maplac/RgbStripWebServer/Images/finished_device.jpg

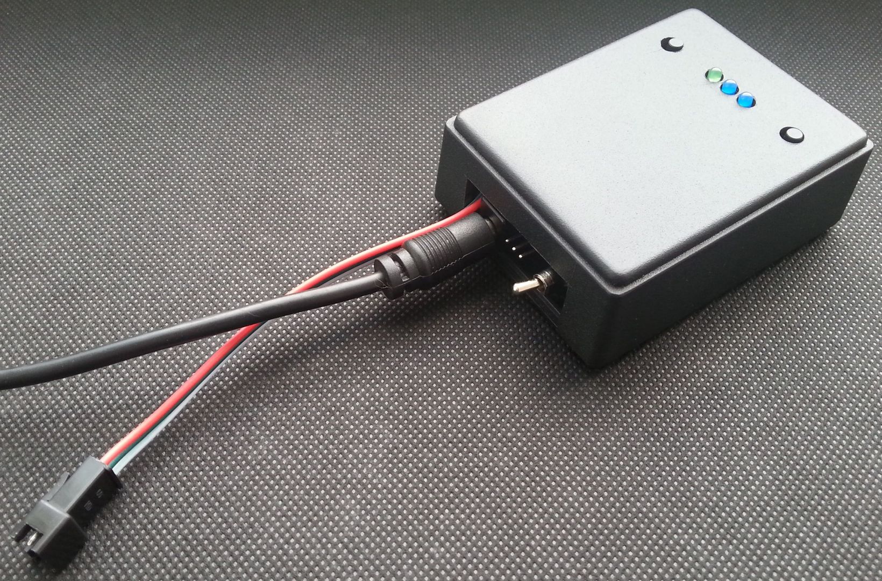
Images/finished_device.jpg
