maplac/RgbStripWebServer/Images/populated_pcb_top.jpg

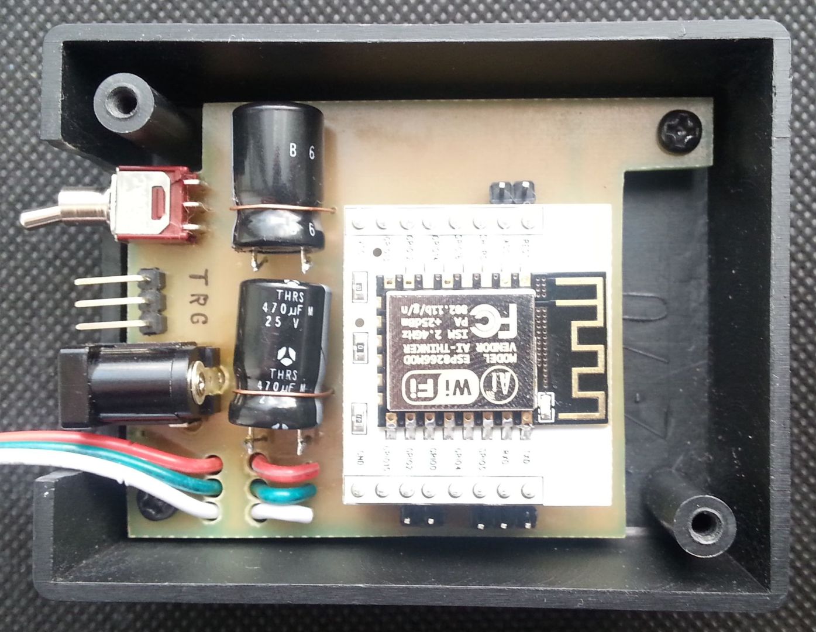
Images/populated_pcb_top.jpg
