maplac/RgbStripWebServer/Images/device_in_use.jpg

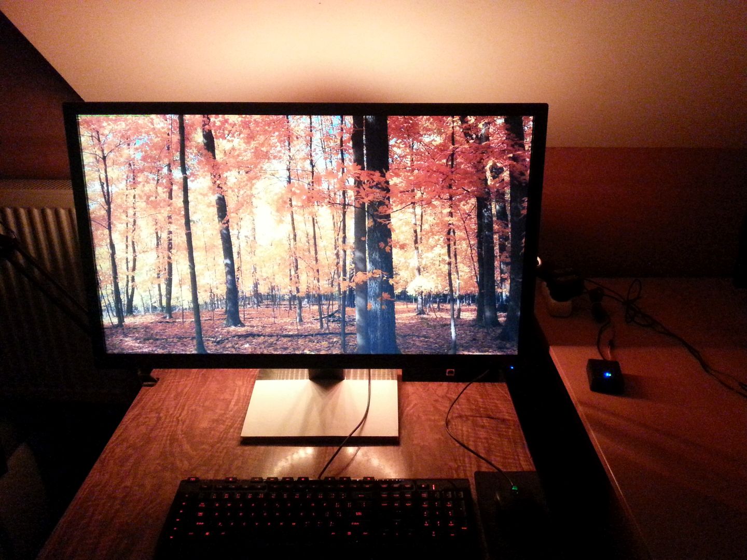
Images/device_in_use.jpg
