maplac/RgbStripWebServer/Images/led_strip_on_cardboard.jpg

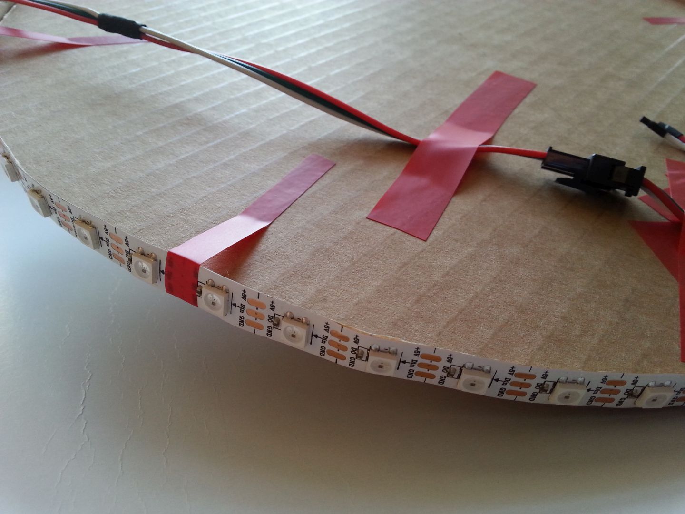
Images/led_strip_on_cardboard.jpg
