maplac/RgbStripWebServer/Images/populated_pcb_bottom.jpg

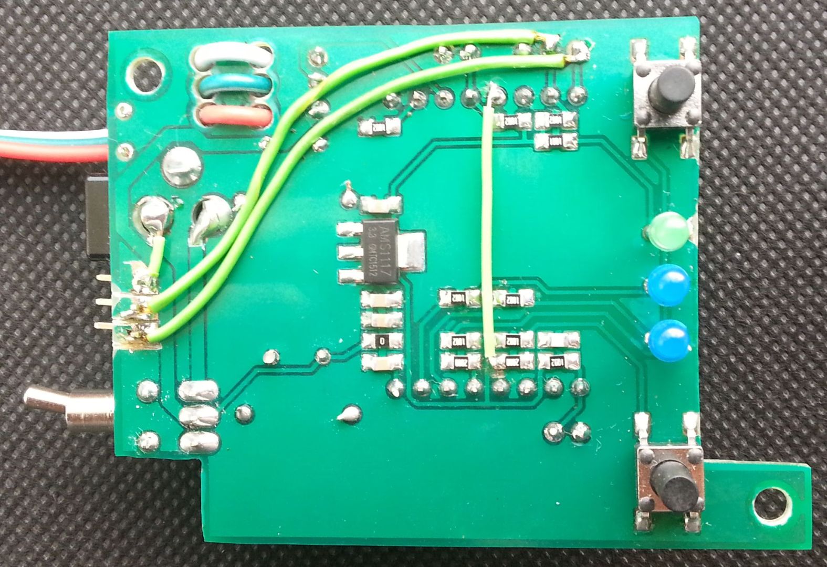
Images/populated_pcb_bottom.jpg
