maplac/RgbStripWebServer/Images/screenshot_home.png

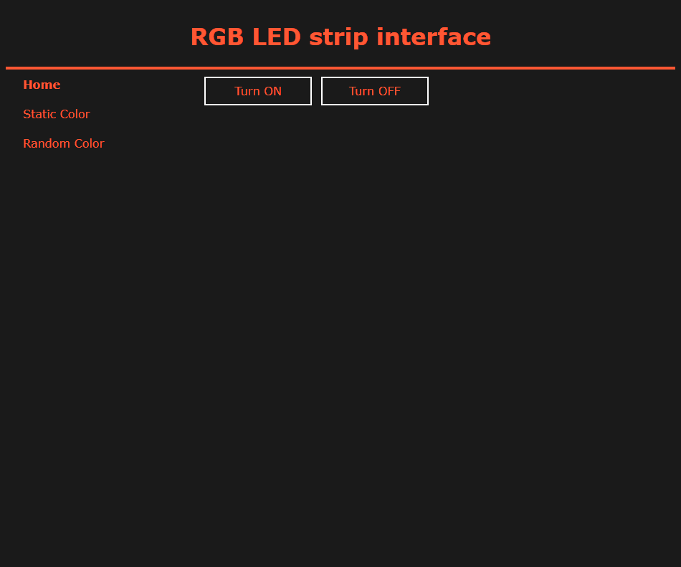
Images/screenshot_home.png
