maplac/RgbStripWebServer/Images/screenshot_random_color.png

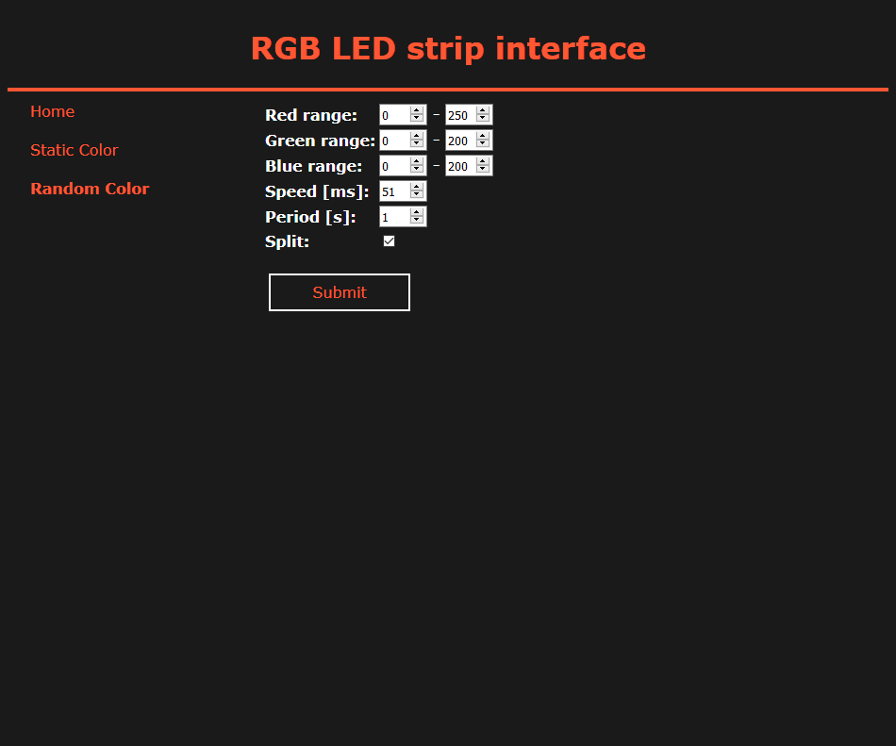
Images/screenshot_random_color.png
