maplac/RgbStripWebServer/Images/screenshot_static_color.png

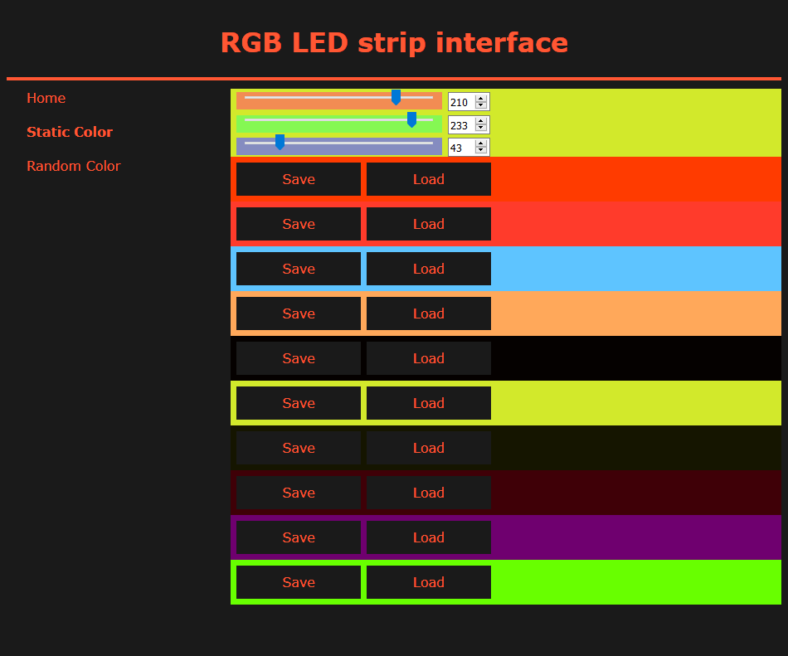
Images/screenshot_static_color.png
