maplac/RgbStripWebServer/PCB/bottom-mask.png

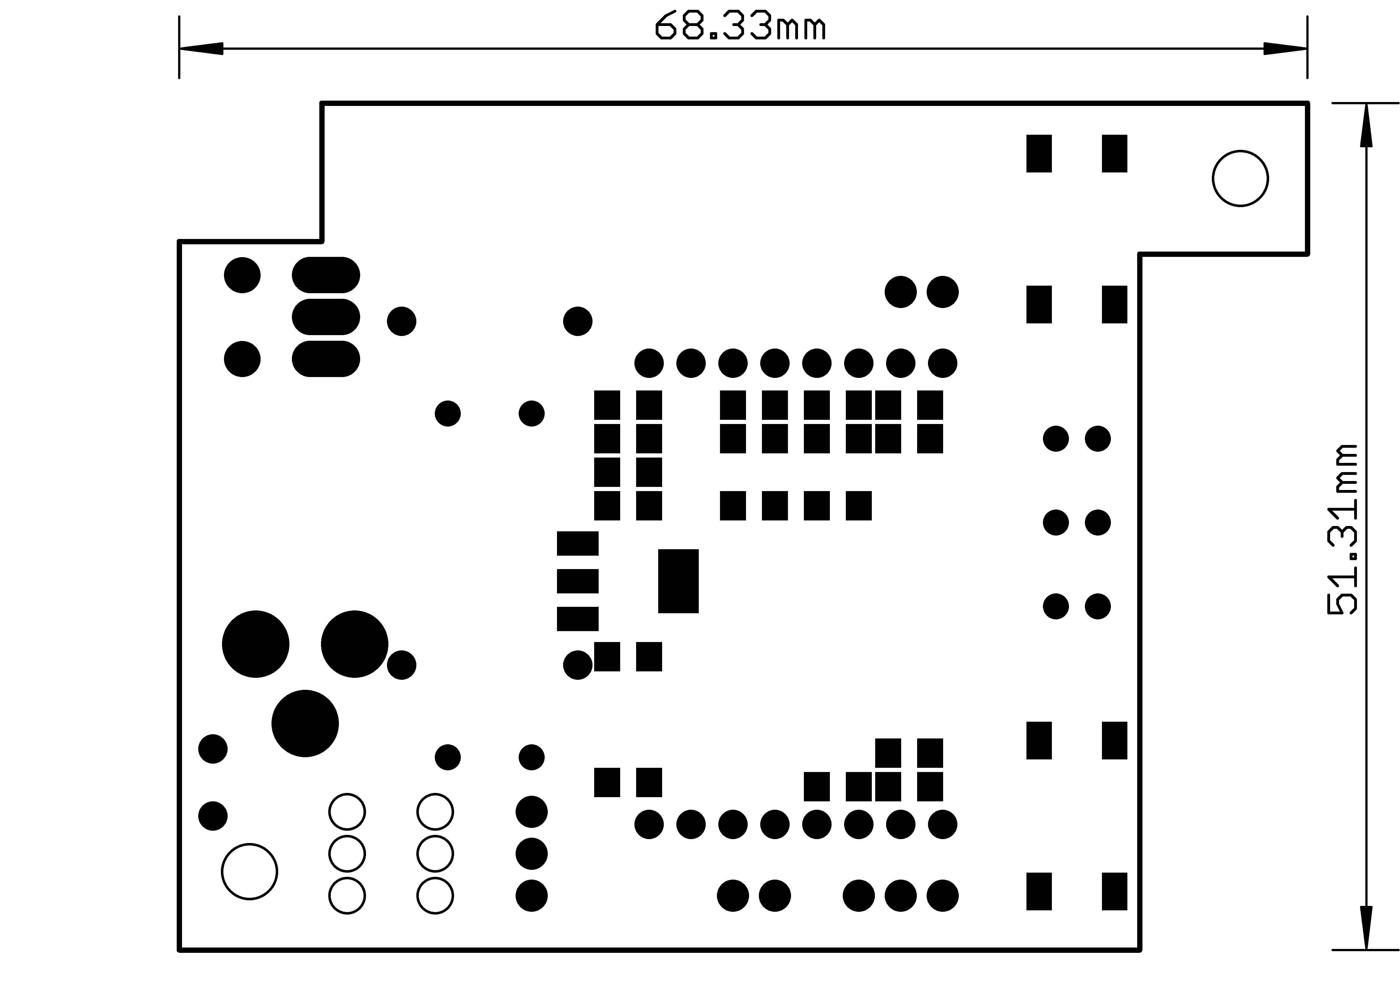
PCB/bottom-mask.png
