maplac/RgbStripWebServer/PCB/bottom.png

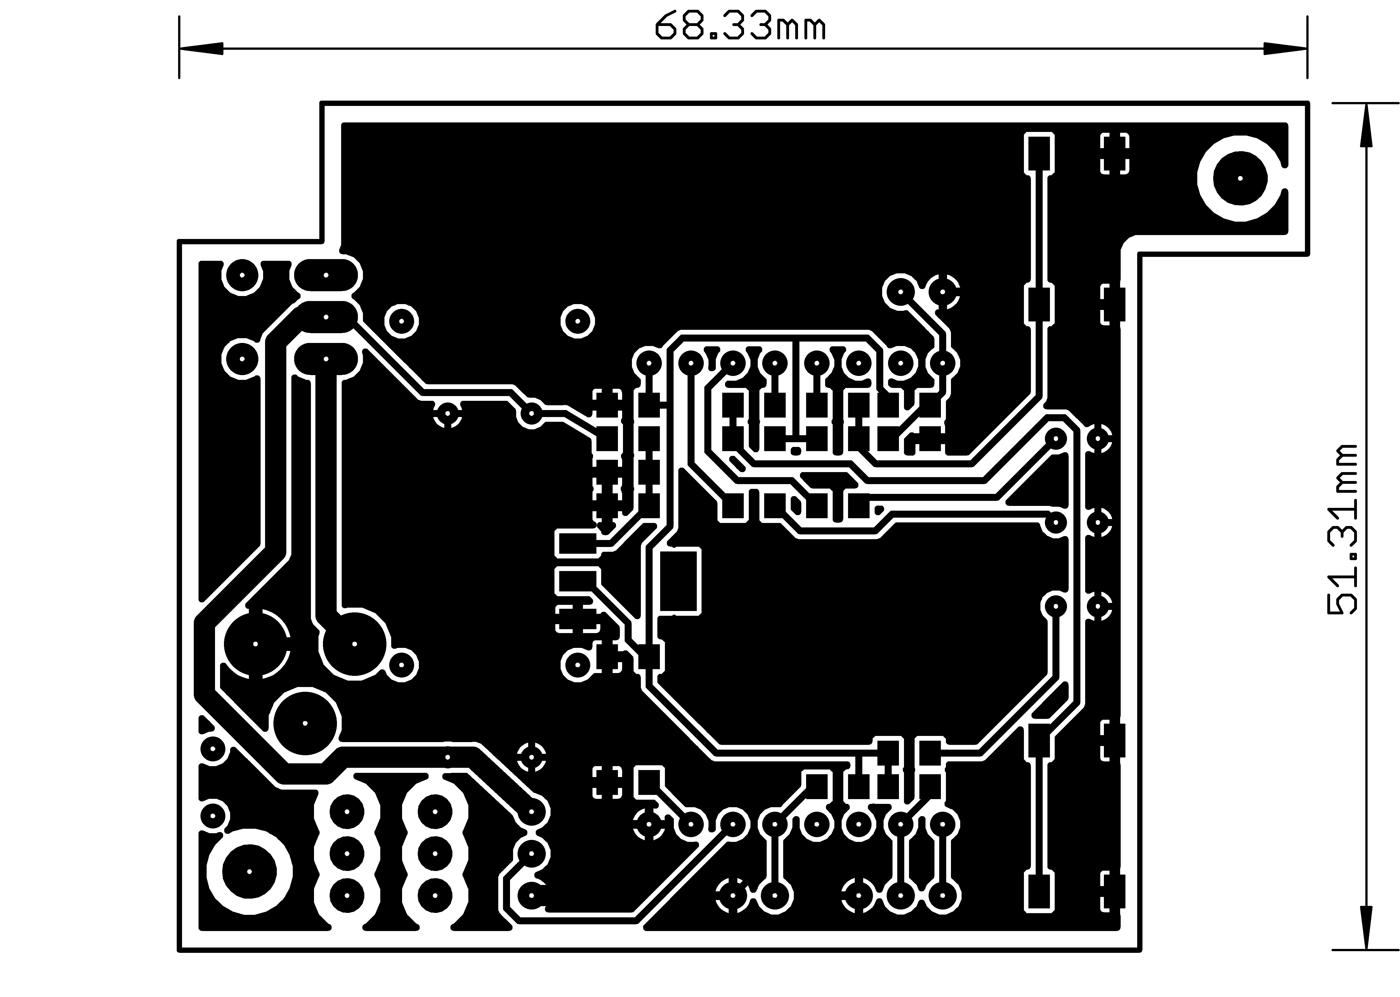
PCB/bottom.png
