maplac/RgbStripWebServer/PCB/schematics.png

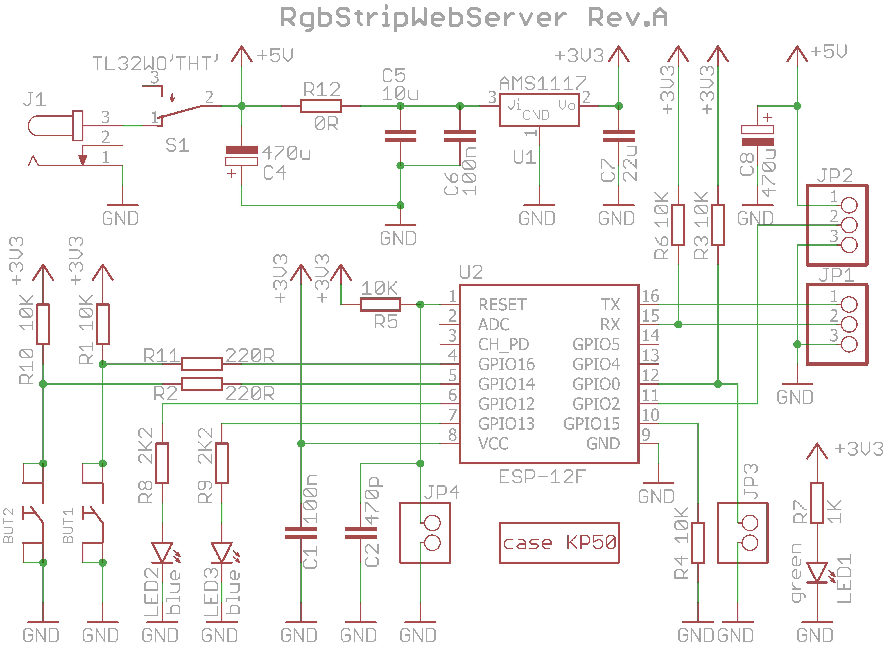
PCB/schematics.png
