maplac/RgbStripWebServer/PCB/bottom-parts-names.png

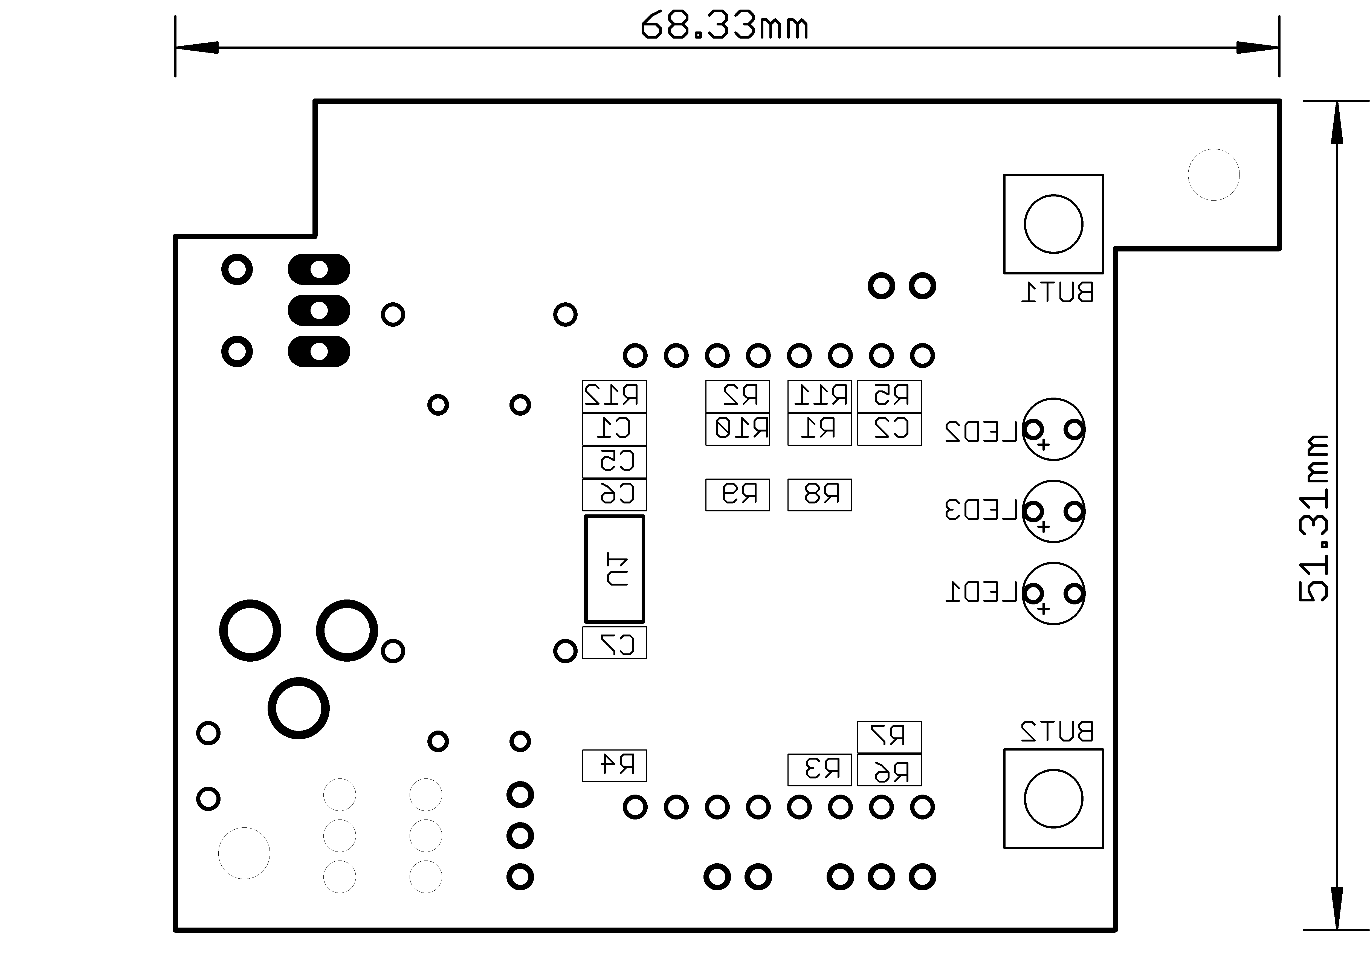
PCB/bottom-parts-names.png
