maplac/RgbStripWebServer/PCB/top-parts.png

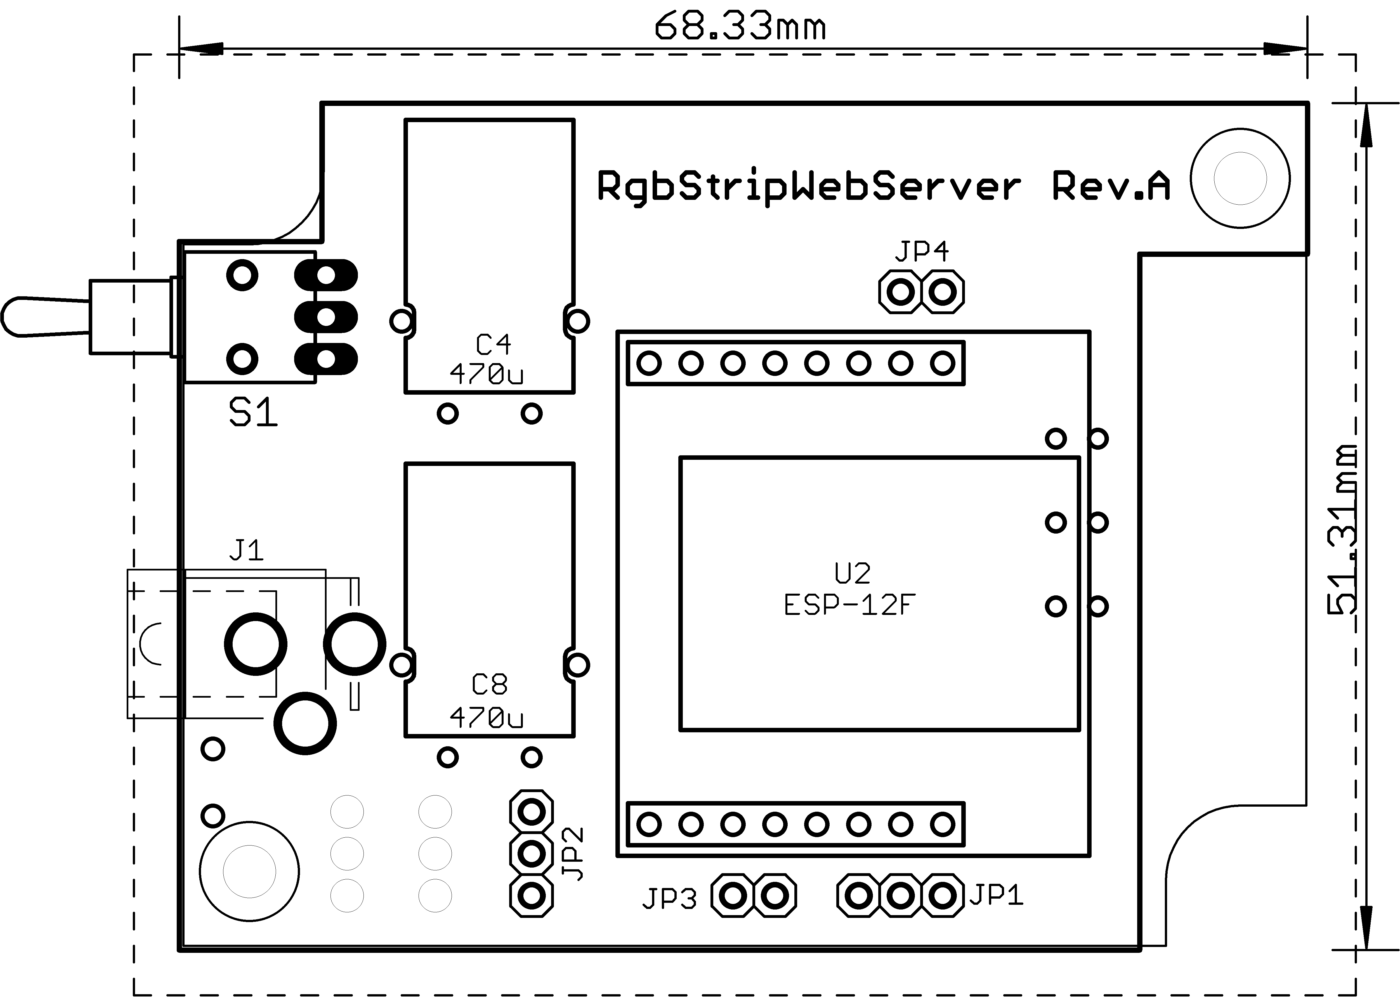
PCB/top-parts.png
