maplac/RgbStripWebServer/PCB/ESP_rgb_led_server_revA.brd

## EAGLE design PCB/ESP_rgb_led_server_revA.brd (2017-05-15)

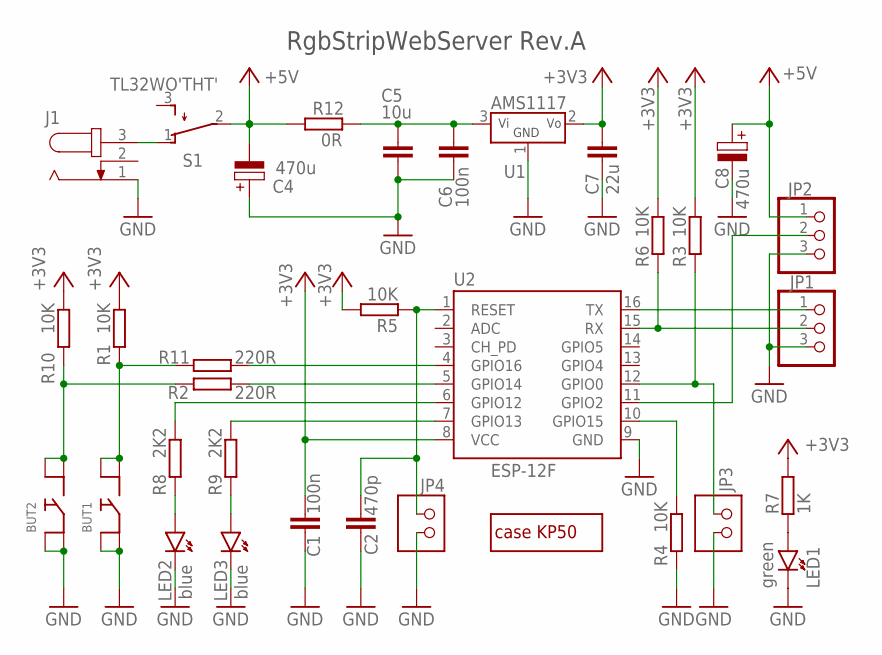
[picture p14: schematic ESP_rgb_led_server_revA.sch]

Parts:
BUT1, BUT2: BUTTON'SMD'; BUTTON_SMD
C1, C6: 100n; C0805
C2: 470p; C0805
C4, C8: 470u; ELYT-10MM/90
C5: 10u; C0805
C7: 22u; C0805
J1: JACK-PLUG1; SPC4078
JP1, JP2: PINHD-3X1
JP3, JP4: PINHD-2X1
LED1: green; LED3MM
LED2, LED3: blue; LED3MM
R1, R3, R4, R5, R6, R10: 10K; R0805
R2, R11: 220R; R0805
R7: 1K; R0805
R8, R9: 2K2; R0805
R12: 0R; R0805
S1: TL32WO'THT'; TL3XWO
U1: AMS1117; SOT223
U2: ESP-12F; ESP-12F-ADAPTER
U$1: CASE-KP50; KP50-CASE

Connections:
+3V3: C1.2, C7.2, R1.2, R3.2, R5.2, R6.2, R7.2, R10.2, U1.2 (VOUT), U2.8 (VCC)
+5V: C4.N (NEG), C8.P (POS), JP2.1, R12.2, S1.2
GND: BUT1.1 (4), BUT1.2, BUT2.1 (4), BUT2.2, C1.1, C2.1, C4.P (POS), C5.1, C6.1, C7.1, C8.N (NEG), J1.1, JP1.3, JP2.3, JP3.2, JP4.2, LED1.K, LED2.K, LED3.K, R4.1, U1.1 (GND), U2.9 (GND)
unnamed: JP1.1, U2.16 (TX)
unnamed: JP3.1, R3.1, U2.12 (GPIO0)
unnamed: C2.2, JP4.1, R5.1, U2.1 (RESET)
unnamed: R4.2, U2.10 (GPIO15)
unnamed: JP1.2, R6.1, U2.15 (RX)
unnamed: JP2.2, U2.11 (GPIO2)
unnamed: J1.3, S1.1 (O)
unnamed: R11.2, U2.4 (GPIO16)
unnamed: LED1.A, R7.1
unnamed: R2.2, U2.5 (GPIO14)
unnamed: R8.2, U2.6 (GPIO12)
unnamed: LED2.A, R8.1
unnamed: R9.2, U2.7 (GPIO13)
unnamed: LED3.A, R9.1
unnamed: BUT2.3 (1), BUT2.4 (3), R2.1, R10.1
unnamed: C5.2, C6.2, R12.1, U1.3 (VIN)
unnamed: BUT1.3 (1), BUT1.4 (3), R1.1, R11.1

Notes on the sheet:
RgbStripWebServer Rev.A

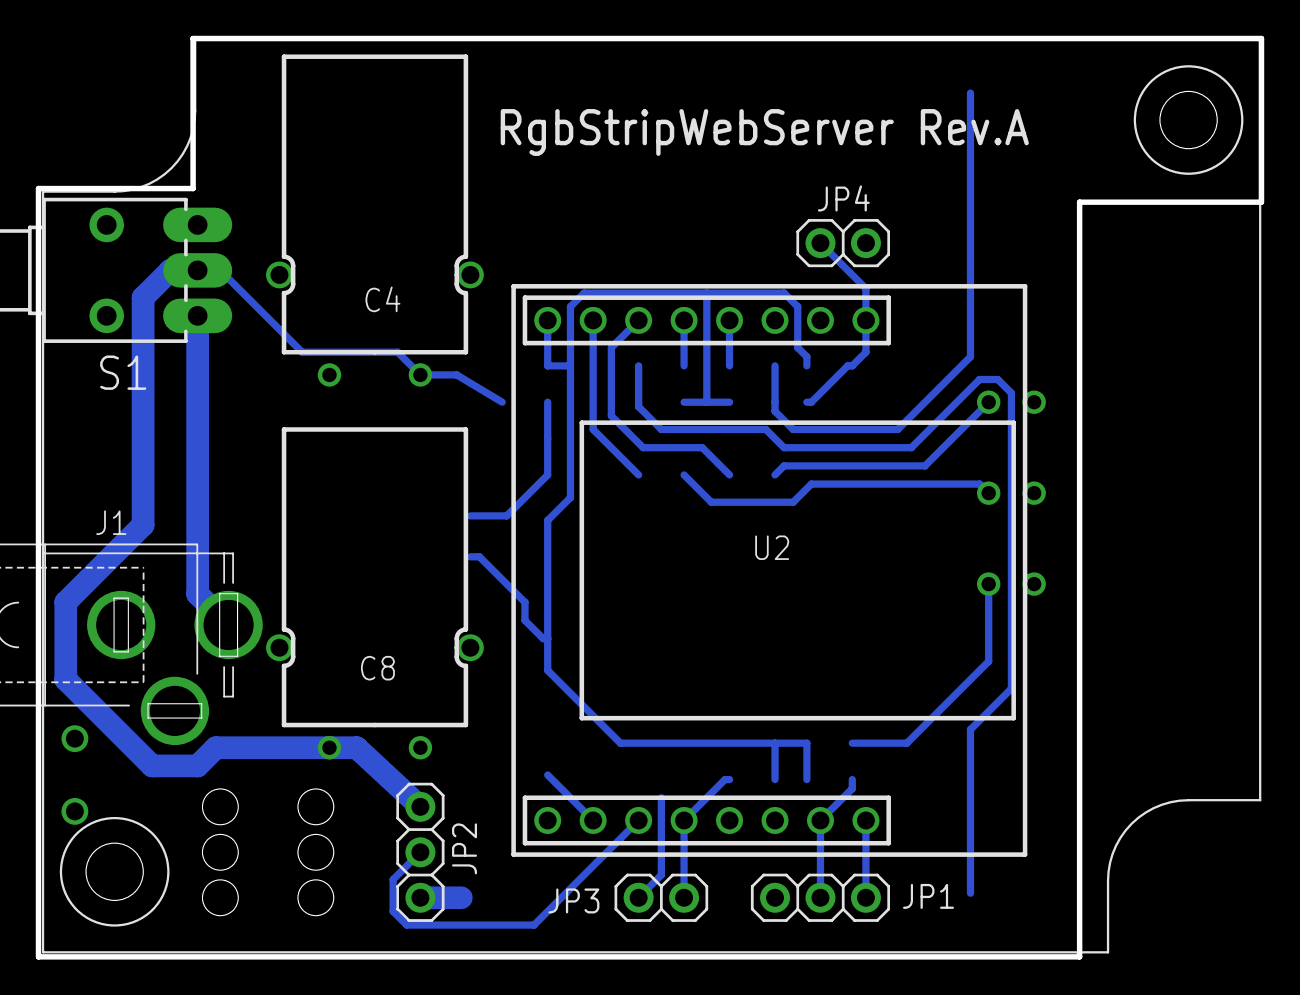
[picture p15: board ESP_rgb_led_server_revA.brd from above]

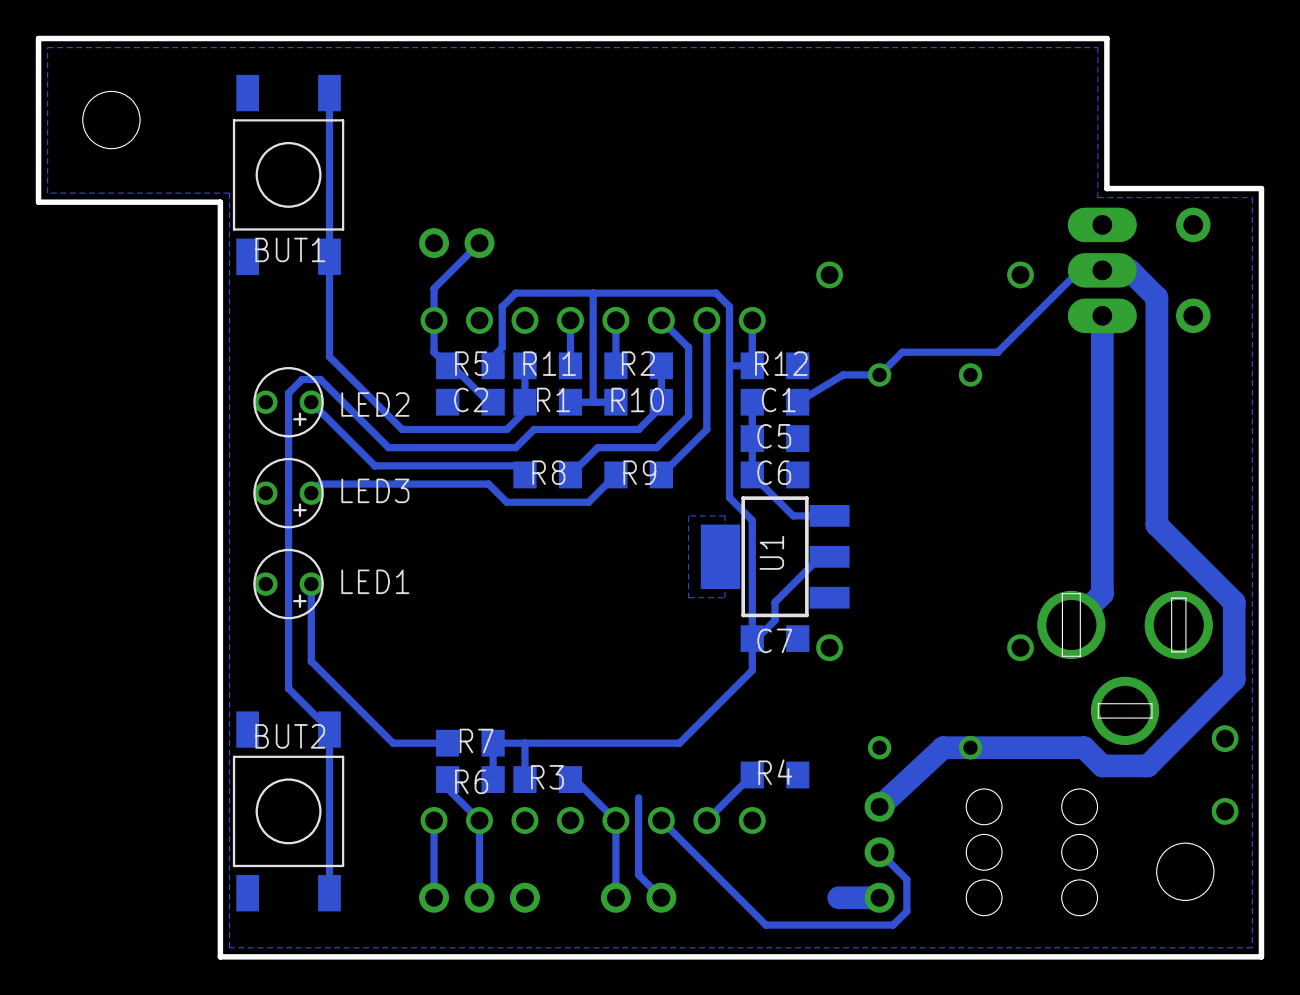
[picture p16: board ESP_rgb_led_server_revA.brd from below]

Board: 2 copper layers, 68.3 x 51.3 mm, 33 parts (23 on the bottom side), 20 nets.
