maplac/RgbStripWebServer/(threads)

Thread 4 (2017-05-15):

THT pads

maplac, 2017-05-15:
Pads for THT components have small diameter and may be easily damaged during drilling.
