maplac/RgbStripWebServer/Firmware/settings.lua

settings={
previousEffect="staticColor",
activeEffect="staticColor",
isOn=true,
staticColor={
color={134,195,255},
savedColors={{7,1,0,},{15,3,0,},{255,10,0,},{255,40,0,},{121,255,5,},{134,195,255,},{69,117,255,},{69,0,255,},{255,174,0,},{255,174,70,},}
},
randomColor={
redRange={50,250},
greenRange={50,200},
blueRange={50,200},
split=true,
speed=80,
period=5
},
secondButton={
colorIndex=2
}
}
