maplac/RgbStripWebServer/(commit log)

2017-05-07 added: schematics and PCB layout
    [ESP_rgb_led_server_revA.brd, ESP_rgb_led_server_revA.sch]
2017-05-15 added: schematics and layout exported as images
    [ESP_rgb_led_server_revA.brd, ESP_rgb_led_server_revA.sch]
2017-06-13 fixed #1: timers for random color effect are correctly stopped
    [random_color.lua]
2017-06-18 resolved #6: added 5 more saved colors to static color effect
    [random_color.lua, settings_functions.lua]
2017-06-19 modified: button debounce timers
2017-12-22 modified: commented debug prints
